Abhishekraj166/Mobile-Actuator-for-Exosuit-/mobile actuator Control and CAD/Housing/FEM results/finalassembly1-Static 1-Displacement-Displacement1.jpg

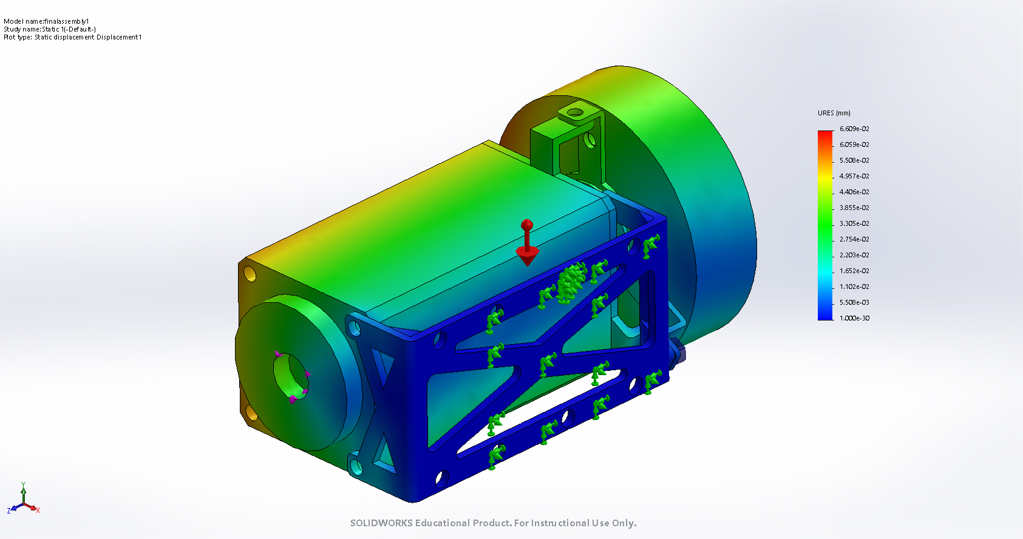
mobile actuator Control and CAD/Housing/FEM results/finalassembly1-Static 1-Displacement-Displacement1.jpg
