Abhishekraj166/Mobile-Actuator-for-Exosuit-/README.md

# Mobile-Actuator-Control-and-CAD-design-for-Exosuit-
