Abhishekraj166/Mobile-Actuator-for-Exosuit-/mobile actuator Control and CAD/Housing/CAD/finalassembly3/subassembly_m1.SLDASM

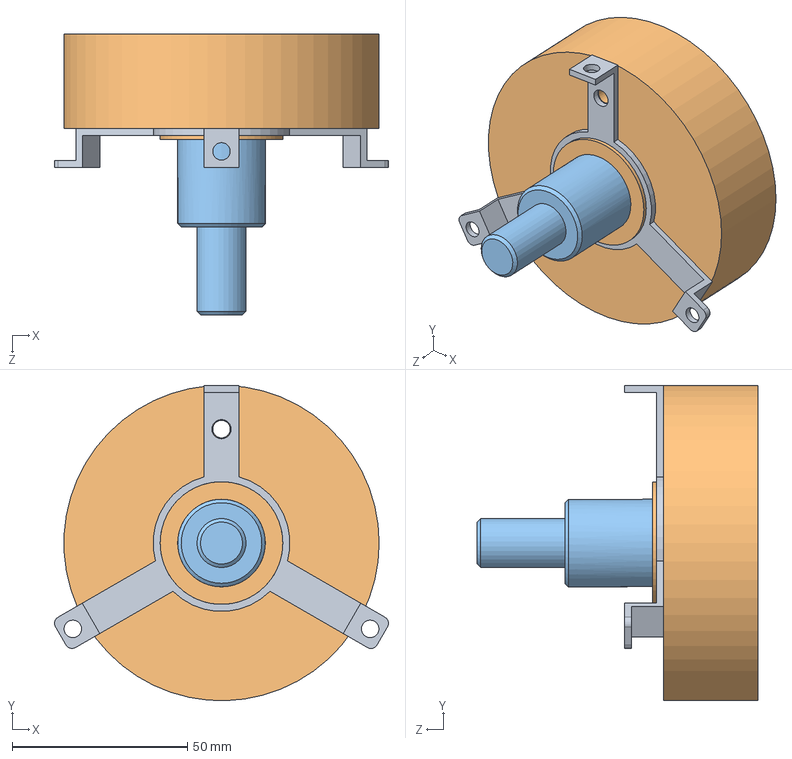
[picture p31: CAD file, 2020-03-06]
mobile actuator Control and CAD/Housing/CAD/finalassembly3/subassembly_m1.SLDASM
95.3 x 90.0 x 80.1 mm
coupling_motor
motor
stepup_adap
