Abhishekraj166/Mobile-Actuator-for-Exosuit-/mobile actuator Control and CAD/Housing/CAD/finalassembly3/subassembly_r1.SLDASM

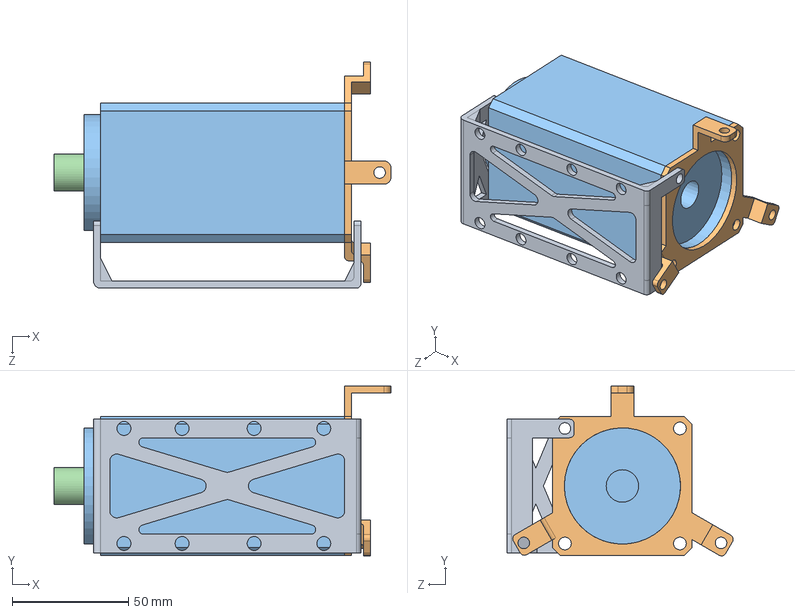
[picture p32: CAD file, 2020-03-06]
mobile actuator Control and CAD/Housing/CAD/finalassembly3/subassembly_r1.SLDASM
145.0 x 73.1 x 97.4 mm
backsupport
coupling_reducer
gearbox
reducer_shaft
