Abhishekraj166/Mobile-Actuator-for-Exosuit-/mobile actuator Control and CAD/Housing/CAD/finalassembly3/finalassembly3.SLDASM

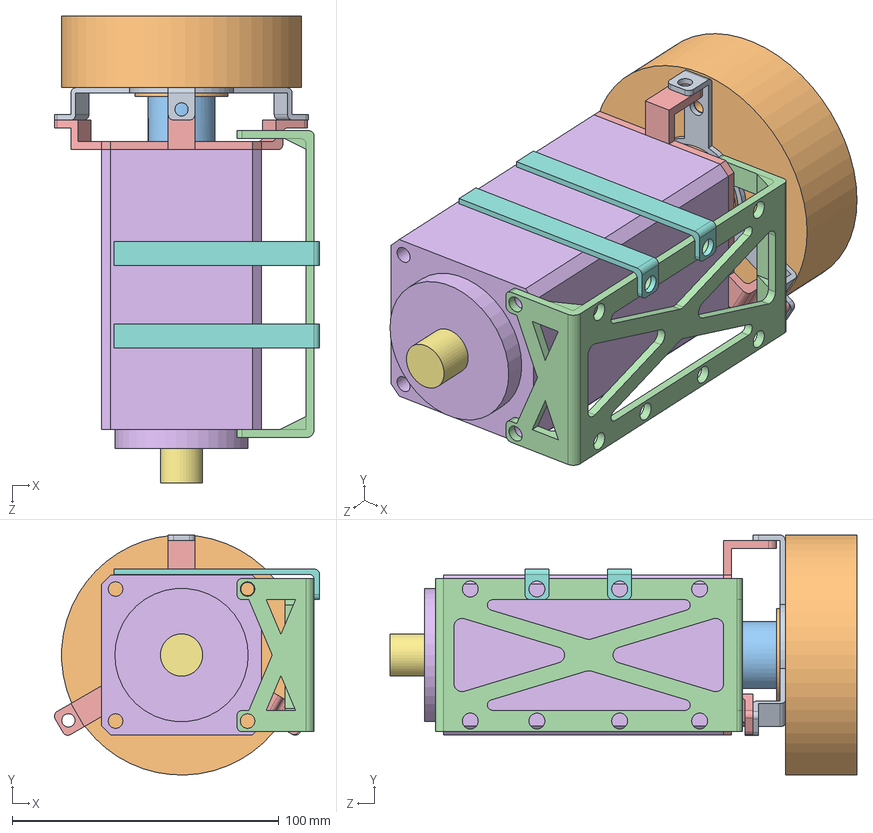
[picture p33: CAD file, 2020-03-06]
mobile actuator Control and CAD/Housing/CAD/finalassembly3/finalassembly3.SLDASM
99.4 x 90.0 x 175.1 mm
coupling_motor
motor
stepup_adap
backsupport
coupling_reducer
gearbox
reducer_shaft
controller support x 2
