Abhishekraj166/Mobile-Actuator-for-Exosuit-/mobile actuator Control and CAD/harness design for exosuits/4. carbon attachement_1.SLDPRT

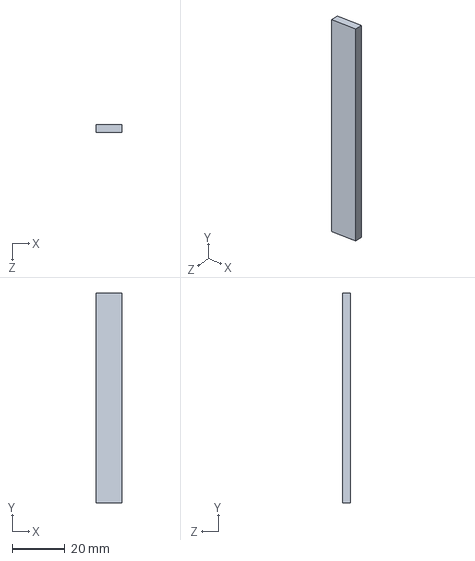
[picture p34: CAD file, 2020-03-06]
mobile actuator Control and CAD/harness design for exosuits/4. carbon attachement_1.SLDPRT
10.0 x 80.0 x 3.00 mm
