Abhishekraj166/Mobile-Actuator-for-Exosuit-/mobile actuator Control and CAD/Housing/3D print/stepup_adap.STL

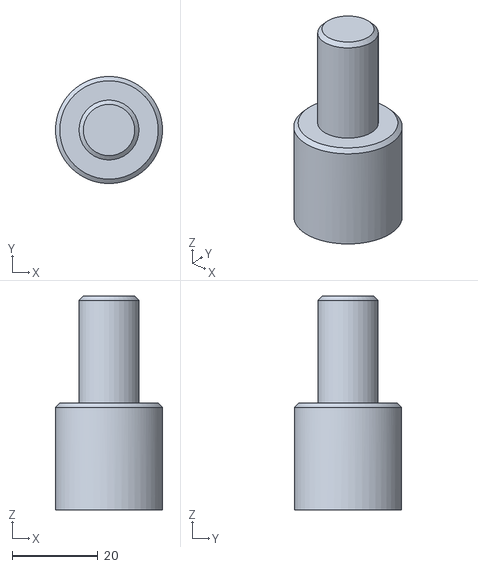
[picture p35: CAD file, 2020-03-06]
mobile actuator Control and CAD/Housing/3D print/stepup_adap.STL
25.0 x 25.0 x 50.0
