Abhishekraj166/Mobile-Actuator-for-Exosuit-/mobile actuator Control and CAD/Housing/CAD/finalassembly3/controller support.SLDPRT

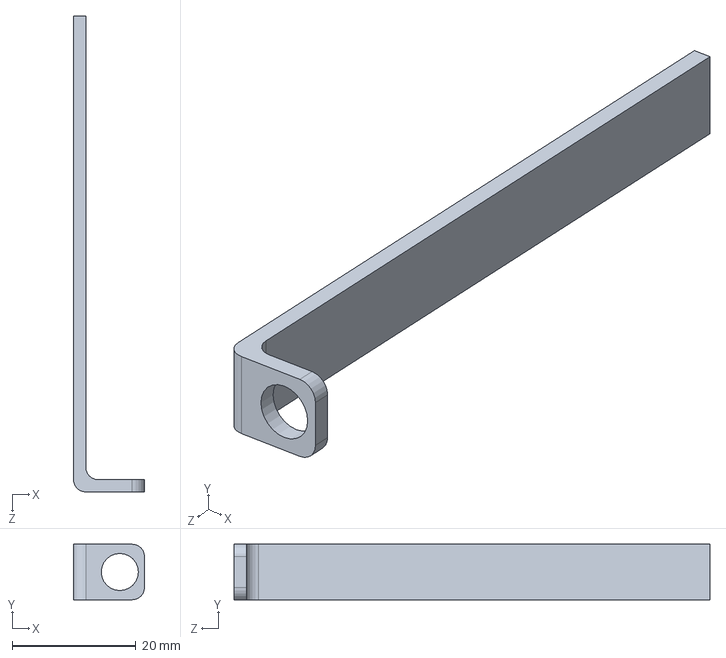
[picture p36: CAD file, 2020-03-06]
mobile actuator Control and CAD/Housing/CAD/finalassembly3/controller support.SLDPRT
11.5 x 9.00 x 77.0 mm
