Abhishekraj166/Mobile-Actuator-for-Exosuit-/mobile actuator Control and CAD/harness design for exosuits/1. Laptop Bag.SLDPRT

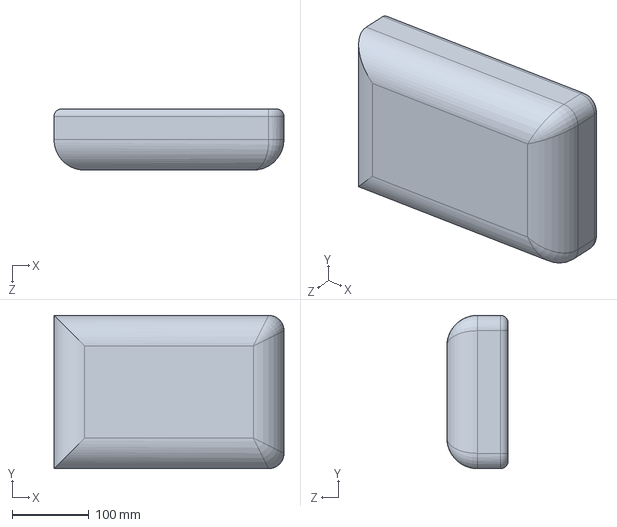
[picture p37: CAD file, 2020-03-06]
mobile actuator Control and CAD/harness design for exosuits/1. Laptop Bag.SLDPRT
300.0 x 200.0 x 80.0 mm
