Abhishekraj166/Mobile-Actuator-for-Exosuit-/mobile actuator Control and CAD/Housing/3D print/coupling_motor.STL

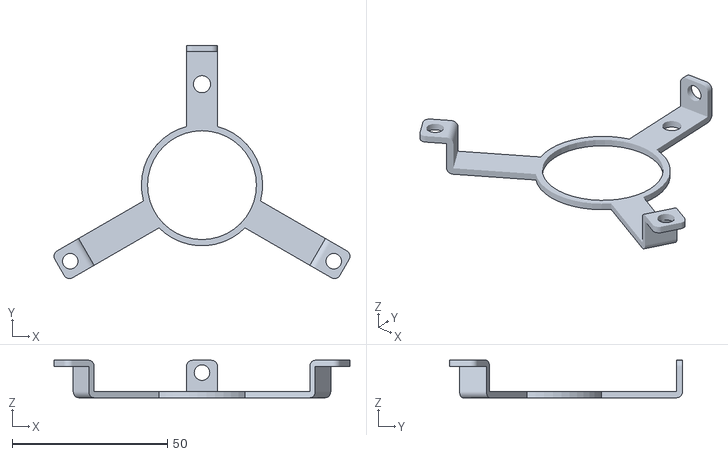
[picture p38: CAD file, 2020-03-06]
mobile actuator Control and CAD/Housing/3D print/coupling_motor.STL
95.3 x 75.1 x 12.1
