Abhishekraj166/Mobile-Actuator-for-Exosuit-/mobile actuator Control and CAD/harness design for exosuits/0. James.SLDPRT

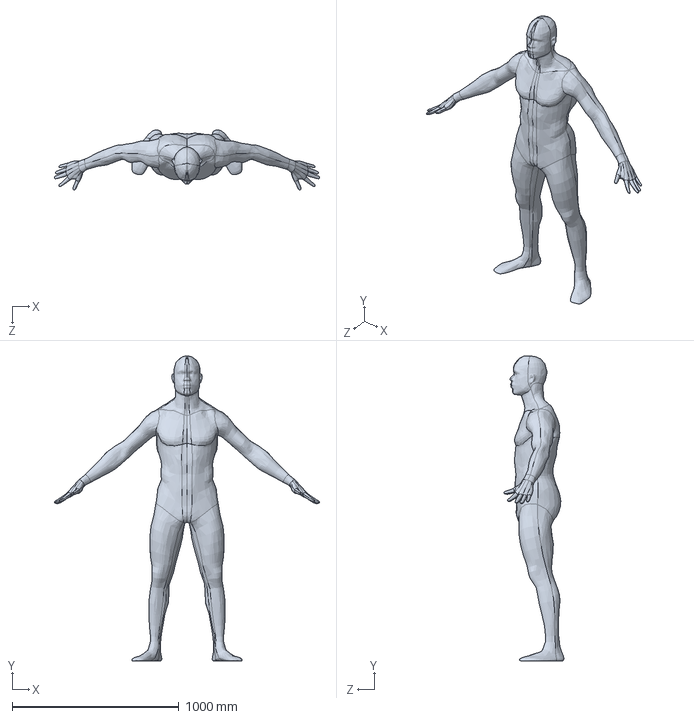
[picture p39: CAD file, 2020-03-06]
mobile actuator Control and CAD/harness design for exosuits/0. James.SLDPRT
1592.3 x 1829.4 x 359.3 mm
