Abhishekraj166/Mobile-Actuator-for-Exosuit-/mobile actuator Control and CAD/Housing/3D print/coupling_reducer.STL

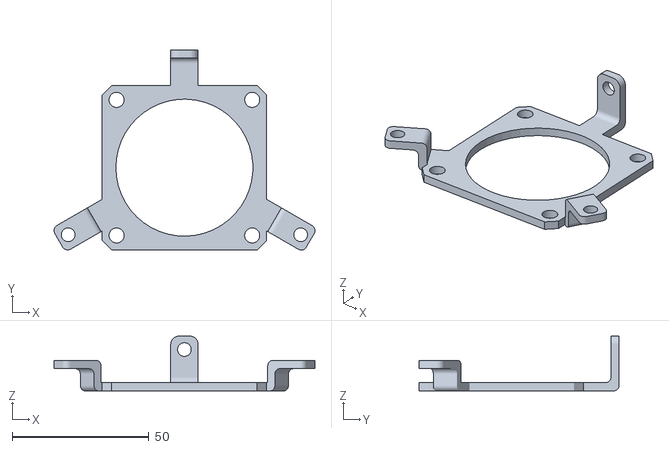
[picture p40: CAD file, 2020-03-06]
mobile actuator Control and CAD/Housing/3D print/coupling_reducer.STL
95.3 x 73.1 x 20.0
