Abhishekraj166/Mobile-Actuator-for-Exosuit-/mobile actuator Control and CAD/harness design for exosuits/6. Vibration absorbing material.SLDPRT

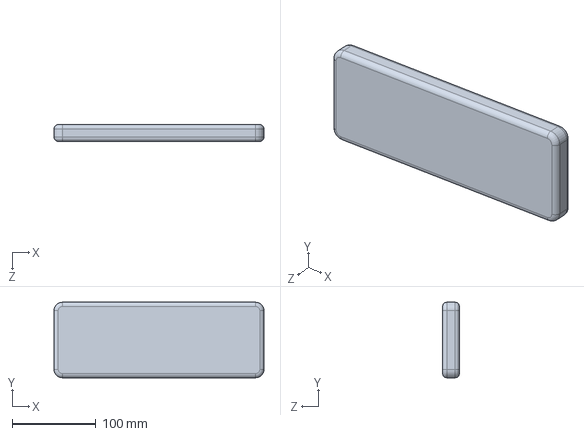
[picture p41: CAD file, 2020-03-06]
mobile actuator Control and CAD/harness design for exosuits/6. Vibration absorbing material.SLDPRT
250.0 x 90.0 x 20.0 mm
