Abhishekraj166/Mobile-Actuator-for-Exosuit-/mobile actuator Control and CAD/Housing/3D print/motor.STL

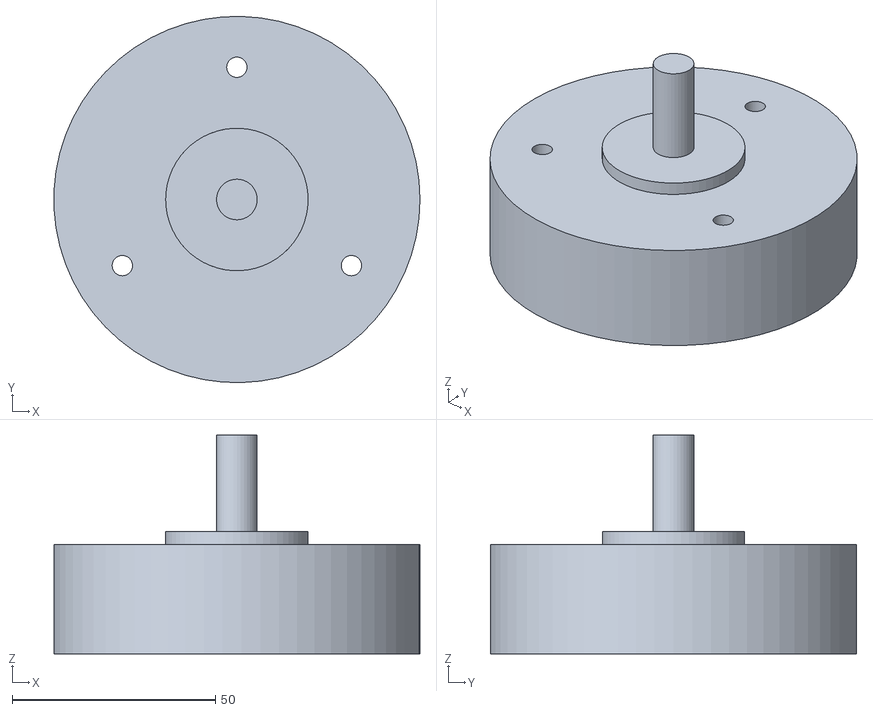
[picture p42: CAD file, 2020-03-06]
mobile actuator Control and CAD/Housing/3D print/motor.STL
89.9 x 90.0 x 53.8
