Abhishekraj166/Mobile-Actuator-for-Exosuit-/mobile actuator Control and CAD/harness design for exosuits/8. MOLLE_Back_support.SLDPRT

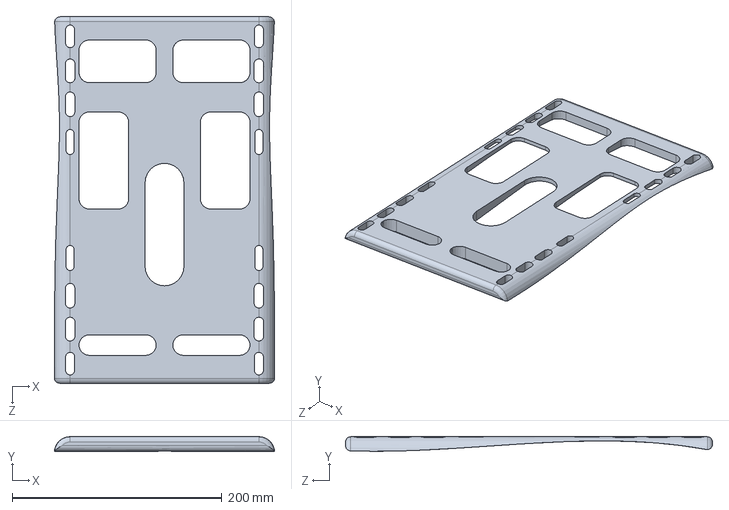
[picture p43: CAD file, 2020-03-06]
mobile actuator Control and CAD/harness design for exosuits/8. MOLLE_Back_support.SLDPRT
209.9 x 13.9 x 350.0 mm
