Abhishekraj166/Mobile-Actuator-for-Exosuit-/mobile actuator Control and CAD/Housing/3D print/backsupport.STL

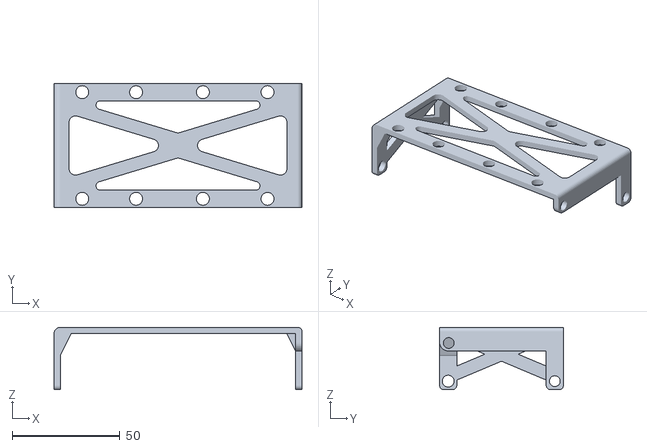
[picture p44: CAD file, 2020-03-06]
mobile actuator Control and CAD/Housing/3D print/backsupport.STL
115.1 x 57.5 x 29.0
