Abhishekraj166/Mobile-Actuator-for-Exosuit-/mobile actuator Control and CAD/harness design for exosuits/2. Belt.SLDPRT

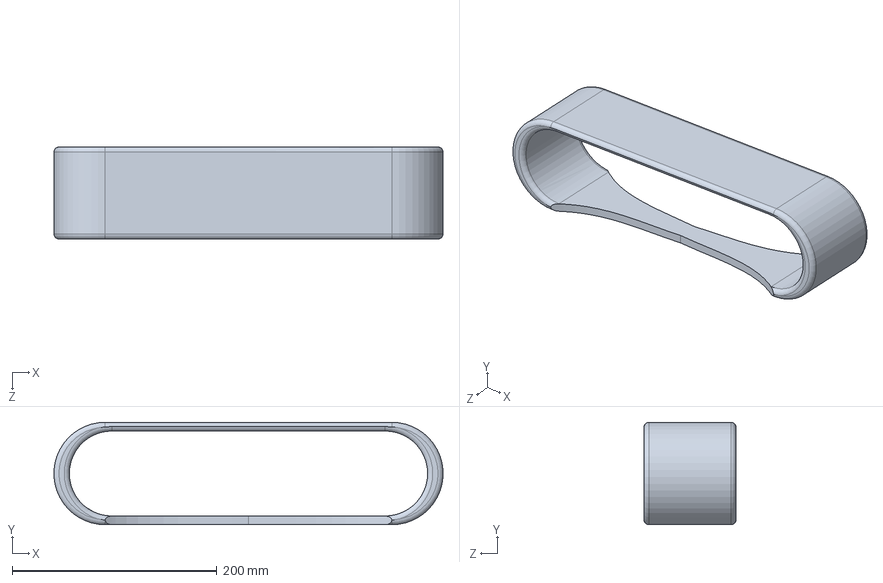
[picture p45: CAD file, 2020-03-06]
mobile actuator Control and CAD/harness design for exosuits/2. Belt.SLDPRT
379.8 x 100.0 x 90.0 mm
