Abhishekraj166/Mobile-Actuator-for-Exosuit-/mobile actuator Control and CAD/Housing/3D print/gearbox.STL

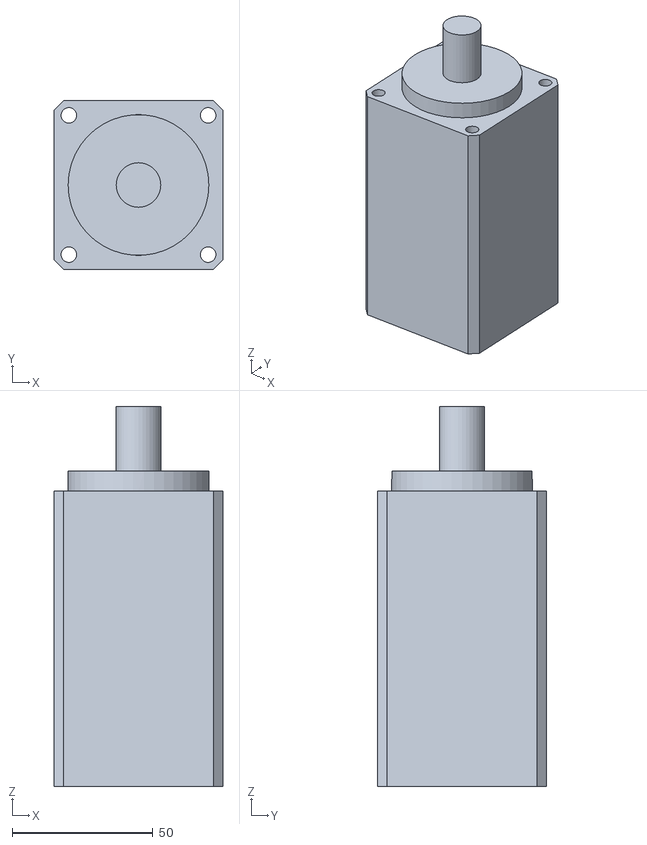
[picture p46: CAD file, 2020-03-06]
mobile actuator Control and CAD/Housing/3D print/gearbox.STL
60.0 x 60.0 x 135.0
