Abhishekraj166/Mobile-Actuator-for-Exosuit-/mobile actuator Control and CAD/Housing/CAD/finalassembly3/motor.SLDPRT

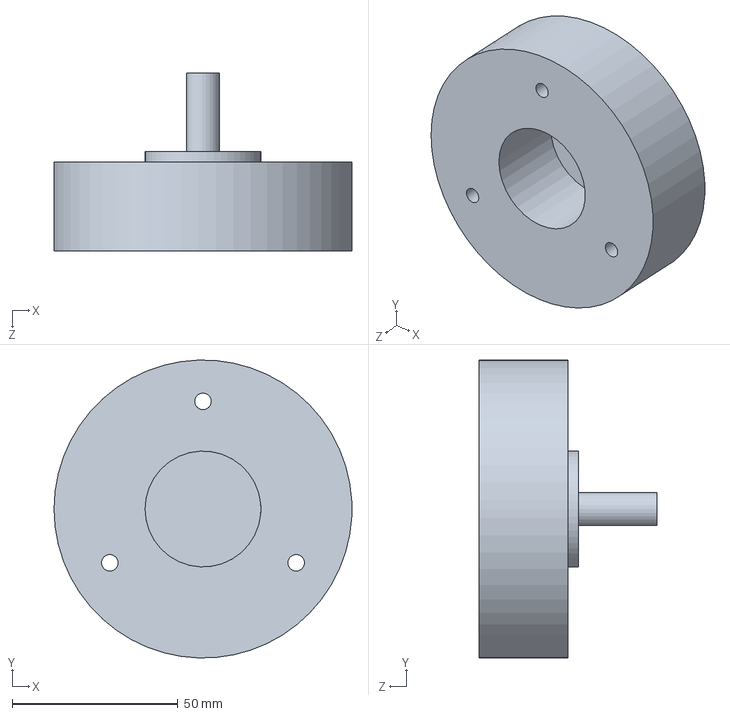
[picture p47: CAD file, 2020-03-06]
mobile actuator Control and CAD/Housing/CAD/finalassembly3/motor.SLDPRT
90.0 x 90.0 x 53.8 mm
