Abhishekraj166/Mobile-Actuator-for-Exosuit-/mobile actuator Control and CAD/harness design for exosuits/3. carbon fiber plate.SLDPRT

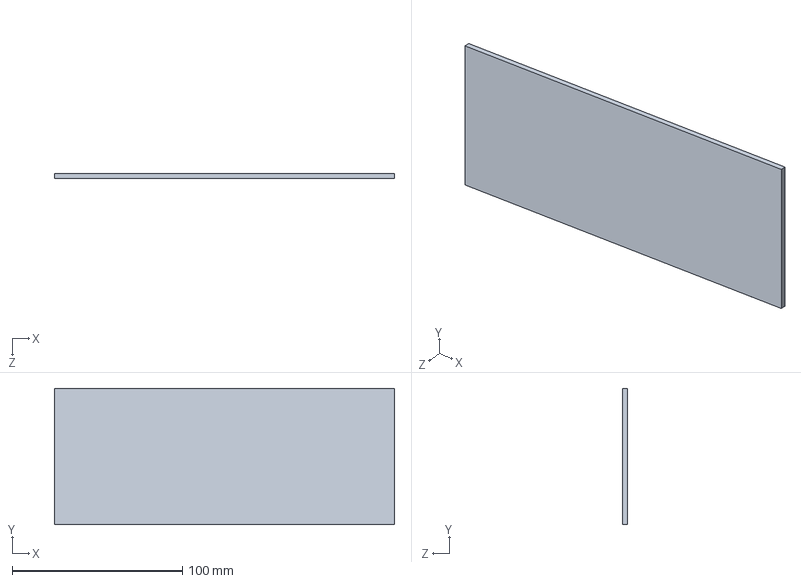
[picture p48: CAD file, 2020-03-06]
mobile actuator Control and CAD/harness design for exosuits/3. carbon fiber plate.SLDPRT
200.0 x 80.0 x 3.00 mm
