Abhishekraj166/Mobile-Actuator-for-Exosuit-/mobile actuator Control and CAD/Housing/CAD/finalassembly3/gearbox.SLDPRT

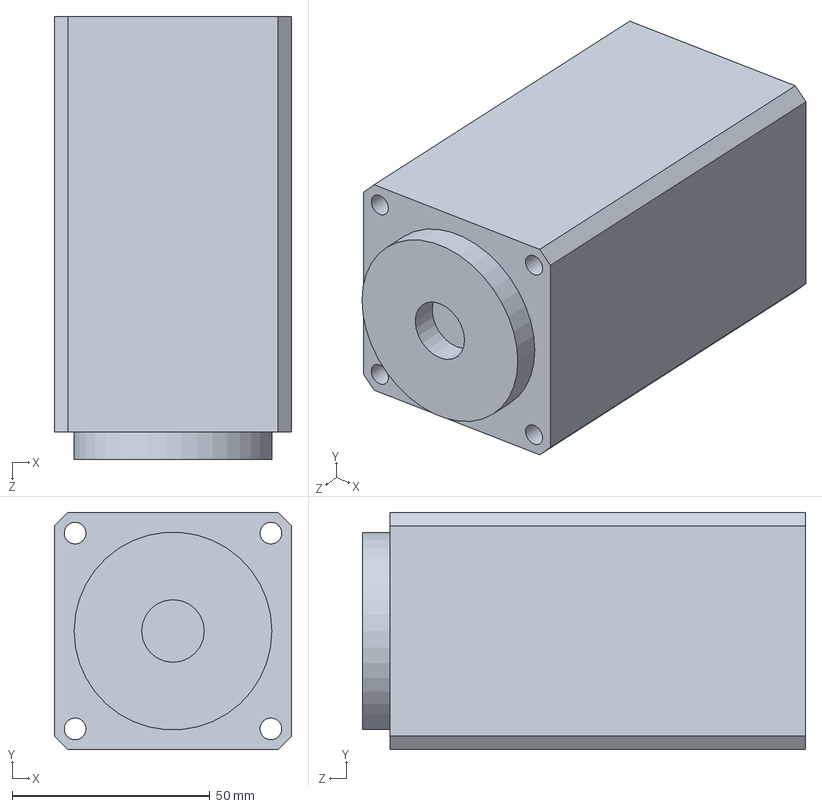
[picture p49: CAD file, 2020-03-06]
mobile actuator Control and CAD/Housing/CAD/finalassembly3/gearbox.SLDPRT
60.0 x 60.0 x 112.0 mm
