Abhishekraj166/Mobile-Actuator-for-Exosuit-/mobile actuator Control and CAD/harness design for exosuits/7. motor.SLDPRT

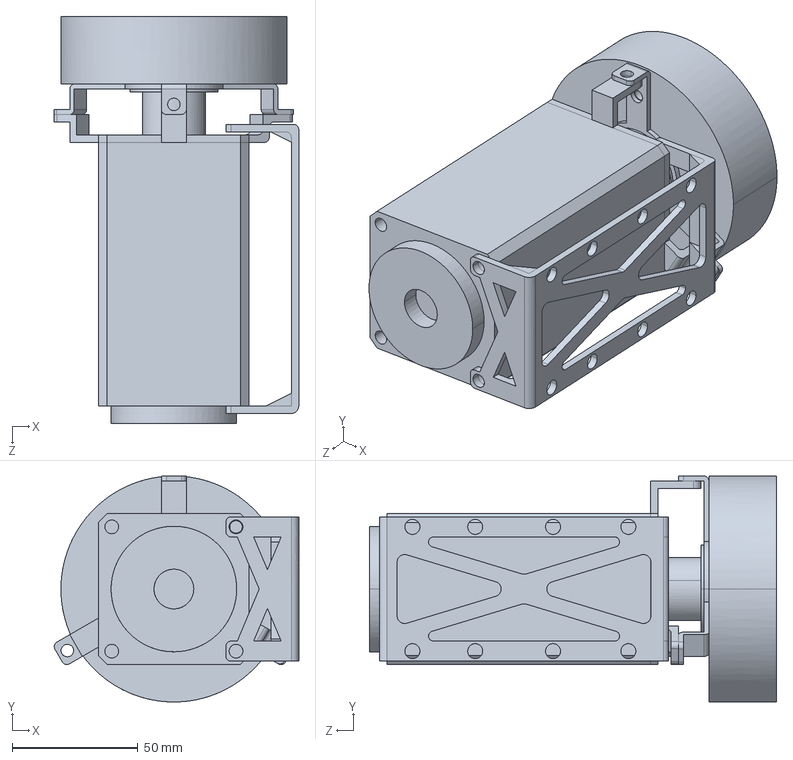
[picture p50: CAD file, 2020-03-06]
mobile actuator Control and CAD/harness design for exosuits/7. motor.SLDPRT
97.4 x 90.0 x 162.1 mm
