Abhishekraj166/Mobile-Actuator-for-Exosuit-/mobile actuator Control and CAD/Housing/CAD/finalassembly3/stepup_adap.SLDPRT

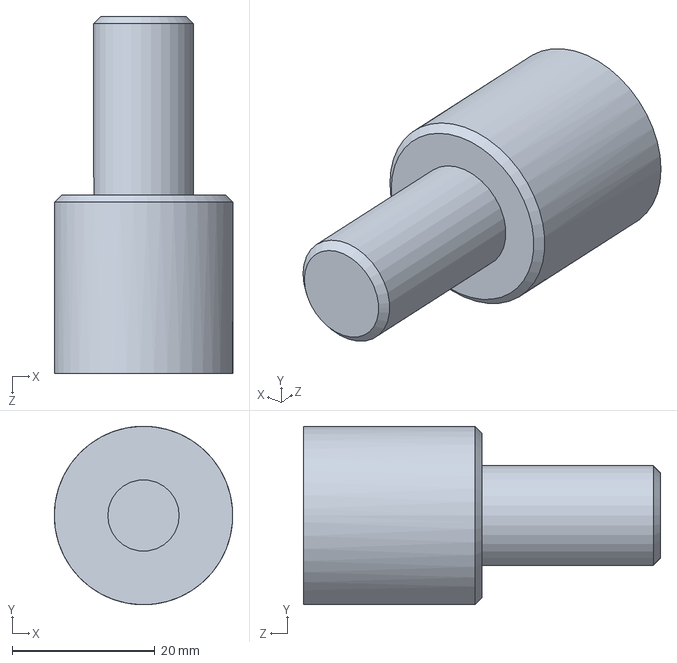
[picture p51: CAD file, 2020-03-06]
mobile actuator Control and CAD/Housing/CAD/finalassembly3/stepup_adap.SLDPRT
25.0 x 25.0 x 50.0 mm
