Abhishekraj166/Mobile-Actuator-for-Exosuit-/mobile actuator Control and CAD/Housing/CAD/finalassembly3/reducer_shaft.SLDPRT

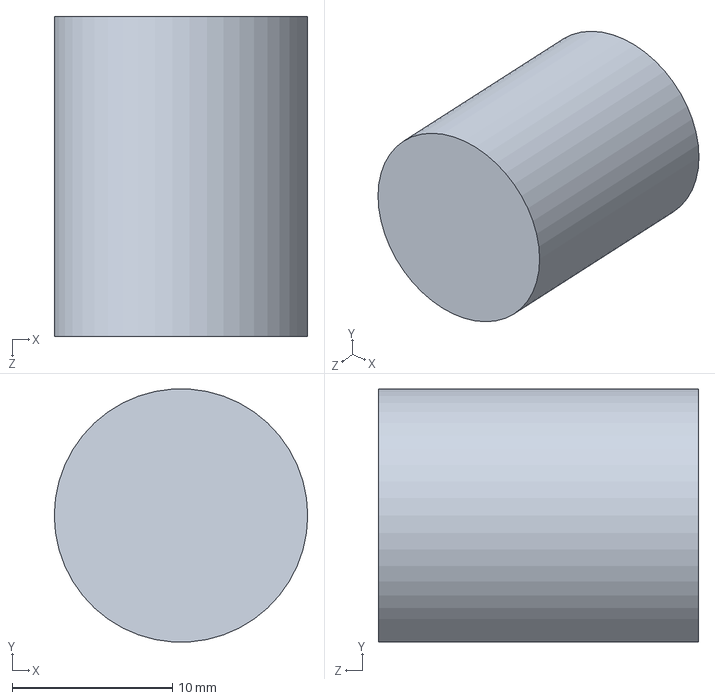
[picture p52: CAD file, 2020-03-06]
mobile actuator Control and CAD/Housing/CAD/finalassembly3/reducer_shaft.SLDPRT
15.8 x 15.8 x 20.0 mm
