Abhishekraj166/Mobile-Actuator-for-Exosuit-/(list of files, cad)

Other CAD files:
mobile actuator Control and CAD/Housing/CAD/finalassembly3/coupling_reducer.SLDPRT
mobile actuator Control and CAD/Housing/CAD/finalassembly3/backsupport.SLDPRT
mobile actuator Control and CAD/harness design for exosuits/5. carbon attachement_2.SLDPRT
mobile actuator Control and CAD/Housing/CAD/finalassembly3/coupling_motor.SLDPRT
